hsa-embedded/stm32lab/anschluss.rst

====== ========= =========== ========= =========== ===========
Pinout     STM32VLDISCOVERY           hsa-pyboard  STM32LAB
------ --------------------- --------------------- -----------
 P1    board pin component   board pin component   component
       name                  name
====== ========= =========== ========= =========== ===========
  1      GND                   GND       
  2      NC                    NC
  3      3V3                  (3V3)
  4      VBAT                 (VBAT)
  5      PC13                 (PC13)
  6      PC14      OSC32_IN
  7      PC15      OSC32_OUT
  8      PD0       OSC_IN
  9      PD1       OSC_OUT
  10     NRST
  11     PC0                                          
  12     PC1
  13     PC2
  14     PC3
  15     PA0      User 
                  Button
  16     PA1      
  17     PA2
  18     PA3
  19     PA4
  20     PA5
  21     PA6
  22     PA7
  23     PC4
  24     PC5
  25     PB0
  26     PB2
  27     PB2
  28     GND
====== ========= =========== ========= =========== ===========

====== ========= =========== ========= =========== ===========
Pinout     STM32VLDISCOVERY           hsa-pyboard  STM32LAB
------ --------------------- --------------------- -----------
 P2    board pin component   board pin component   component
       name                  name
====== ========= =========== ========= =========== ===========
  1      GND                   GND       
  2      PC6      
  3      PC7
  4      PC8      LED_BL
  5      PC9      LED_GR
  6      PA8      MC0         
  7      PA9      
  8      PA10
  9      PA11
  10     PA12
  11     PA13     JTAG
                  JTMS
                  SWDIO                       
  12     PA14     JTAG
                  JTCK 
                  SWCLK                       
  13     PA15     JTAG
  14     PC10     
  15     PC11                     
  16     PC12
  17     PD2 
  18     PB3      JTAG JTDO
  19     PB4      JTAG 
                  NJTRST
  20     PB5      
  21     PB6
  22     PB7
  23     BOOT0    BOOT0
  24     PB8      
  25     PB9
  26     EXT_5V   
  27     NC
  28     GND
====== ========= =========== ========= =========== ===========

====== ========= =========== ========= =========== ===========
Pinout     STM32VLDISCOVERY           hsa-pyboard  STM32LAB
------ --------------------- --------------------- -----------
 P3    board pin component   board pin component   component
       name                  name
====== ========= =========== ========= =========== ===========
  1      PB10                 PB10
  2      PB11                 PB11      
  3      PB12                 PB12
  4      PB13                 PB13
  5      PB14                 PB14
  6      PB15                 PB15
====== ========= =========== ========= =========== ===========
