hsa-embedded/stm32lab/Software/examples/usart/wire.txt

USART Wiring:

PA9  -> RX (USB-to-Serial)
PA10 -> TX (USB-to-Serial)

see media/wire.jpg
