hsa-embedded/stm32lab/Design/20140815/hsa_stm32_board.brd

## EAGLE design Design/20140815/hsa_stm32_board.brd (2014-10-14)

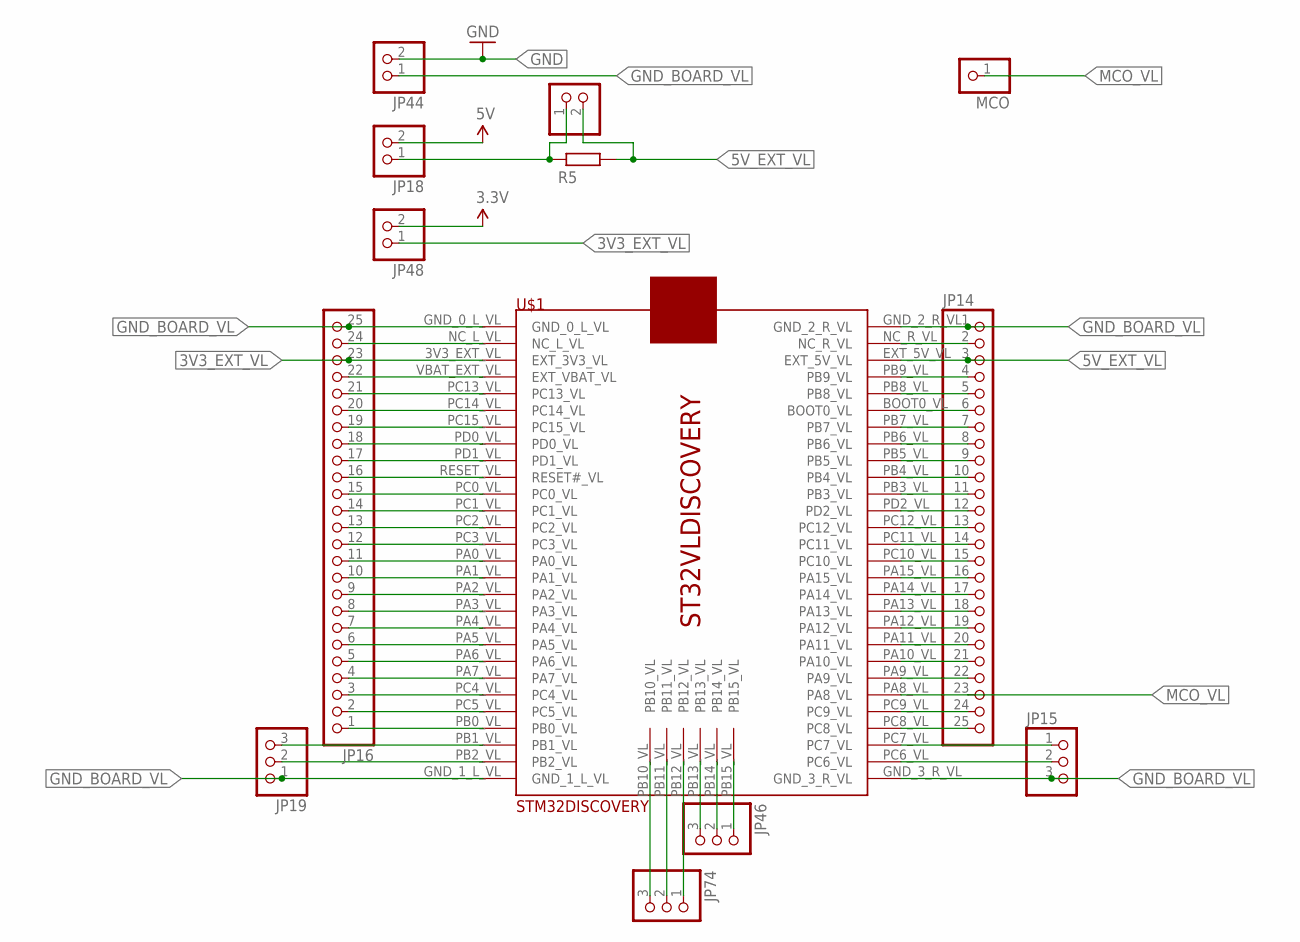
[picture p1: schematic hsa_stm32_board.sch, sheet 1]

Parts:
JP14, JP16: PINHD-1X25; 1X25
JP15, JP19, JP46, JP74: PINHD-1X3; 1X03
JP18, JP44, JP48, JP75: PINHD-1X2/90; 1X02/90
MCO: PINHD-1X1; 1X01
R5: R-EU_0207/10; 0207/10
U$1: STM32DISCOVERY

Connections:
3.3V: JP48.2; also elsewhere on the board
3V3_EXT_VL: JP16.23, JP48.1, U$1.3V3_EXT_VL (EXT_3V3_VL)
5V: JP18.2; also elsewhere on the board
5V_EXT_VL: JP14.3, JP75.2, R5.2, U$1.EXT_5V_VL
GND: JP44.2; also elsewhere on the board
GND_BOARD_VL: JP14.1, JP15.3, JP16.25, JP19.1, JP44.1, U$1.GND_0_L_VL, U$1.GND_1_L_VL, U$1.GND_2_R_VL, U$1.GND_3_R_VL
MCO_VL: JP14.23, MCO.1, U$1.PA8_VL
unnamed: JP18.1, JP75.1, R5.1
unnamed: JP14.2, U$1.NC_R_VL
unnamed: JP14.4, U$1.PB9_VL
unnamed: JP14.5, U$1.PB8_VL
unnamed: JP14.6, U$1.BOOT0_VL
unnamed: JP14.7, U$1.PB7_VL
unnamed: JP14.8, U$1.PB6_VL
unnamed: JP14.9, U$1.PB5_VL
unnamed: JP14.10, U$1.PB4_VL
unnamed: JP14.11, U$1.PB3_VL
unnamed: JP14.12, U$1.PD2_VL
unnamed: JP14.13, U$1.PC12_VL
unnamed: JP14.14, U$1.PC11_VL
unnamed: JP14.15, U$1.PC10_VL
unnamed: JP14.16, U$1.PA15_VL
unnamed: JP14.17, U$1.PA14_VL
unnamed: JP14.18, U$1.PA13_VL
unnamed: JP14.19, U$1.PA12_VL
unnamed: JP14.20, U$1.PA11_VL
unnamed: JP14.21, U$1.PA10_VL
unnamed: JP14.22, U$1.PA9_VL
unnamed: JP14.24, U$1.PC9_VL
unnamed: JP14.25, U$1.PC8_VL
unnamed: JP15.1, U$1.PC7_VL
unnamed: JP15.2, U$1.PC6_VL
unnamed: JP16.1, U$1.PB0_VL
unnamed: JP16.2, U$1.PC5_VL
unnamed: JP16.3, U$1.PC4_VL
unnamed: JP16.4, U$1.PA7_VL
unnamed: JP16.5, U$1.PA6_VL
unnamed: JP16.6, U$1.PA5_VL
unnamed: JP16.7, U$1.PA4_VL
unnamed: JP16.8, U$1.PA3_VL
unnamed: JP16.9, U$1.PA2_VL
unnamed: JP16.10, U$1.PA1_VL
unnamed: JP16.11, U$1.PA0_VL
unnamed: JP16.12, U$1.PC3_VL
unnamed: JP16.13, U$1.PC2_VL
unnamed: JP16.14, U$1.PC1_VL
unnamed: JP16.15, U$1.PC0_VL
unnamed: JP16.16, U$1.RESET_VL (RESET#_VL)
unnamed: JP16.17, U$1.PD1_VL
unnamed: JP16.18, U$1.PD0_VL
unnamed: JP16.19, U$1.PC15_VL
unnamed: JP16.20, U$1.PC14_VL
unnamed: JP16.21, U$1.PC13_VL
unnamed: JP16.22, U$1.VBAT_EXT_VL (EXT_VBAT_VL)
unnamed: JP16.24, U$1.NC_L_VL
unnamed: JP19.2, U$1.PB2_VL
unnamed: JP19.3, U$1.PB1_VL
unnamed: JP46.1, U$1.PB15_VL
unnamed: JP46.2, U$1.PB14_VL
unnamed: JP46.3, U$1.PB13_VL
unnamed: JP74.1, U$1.PB12_VL
unnamed: JP74.2, U$1.PB11_VL
unnamed: JP74.3, U$1.PB10_VL

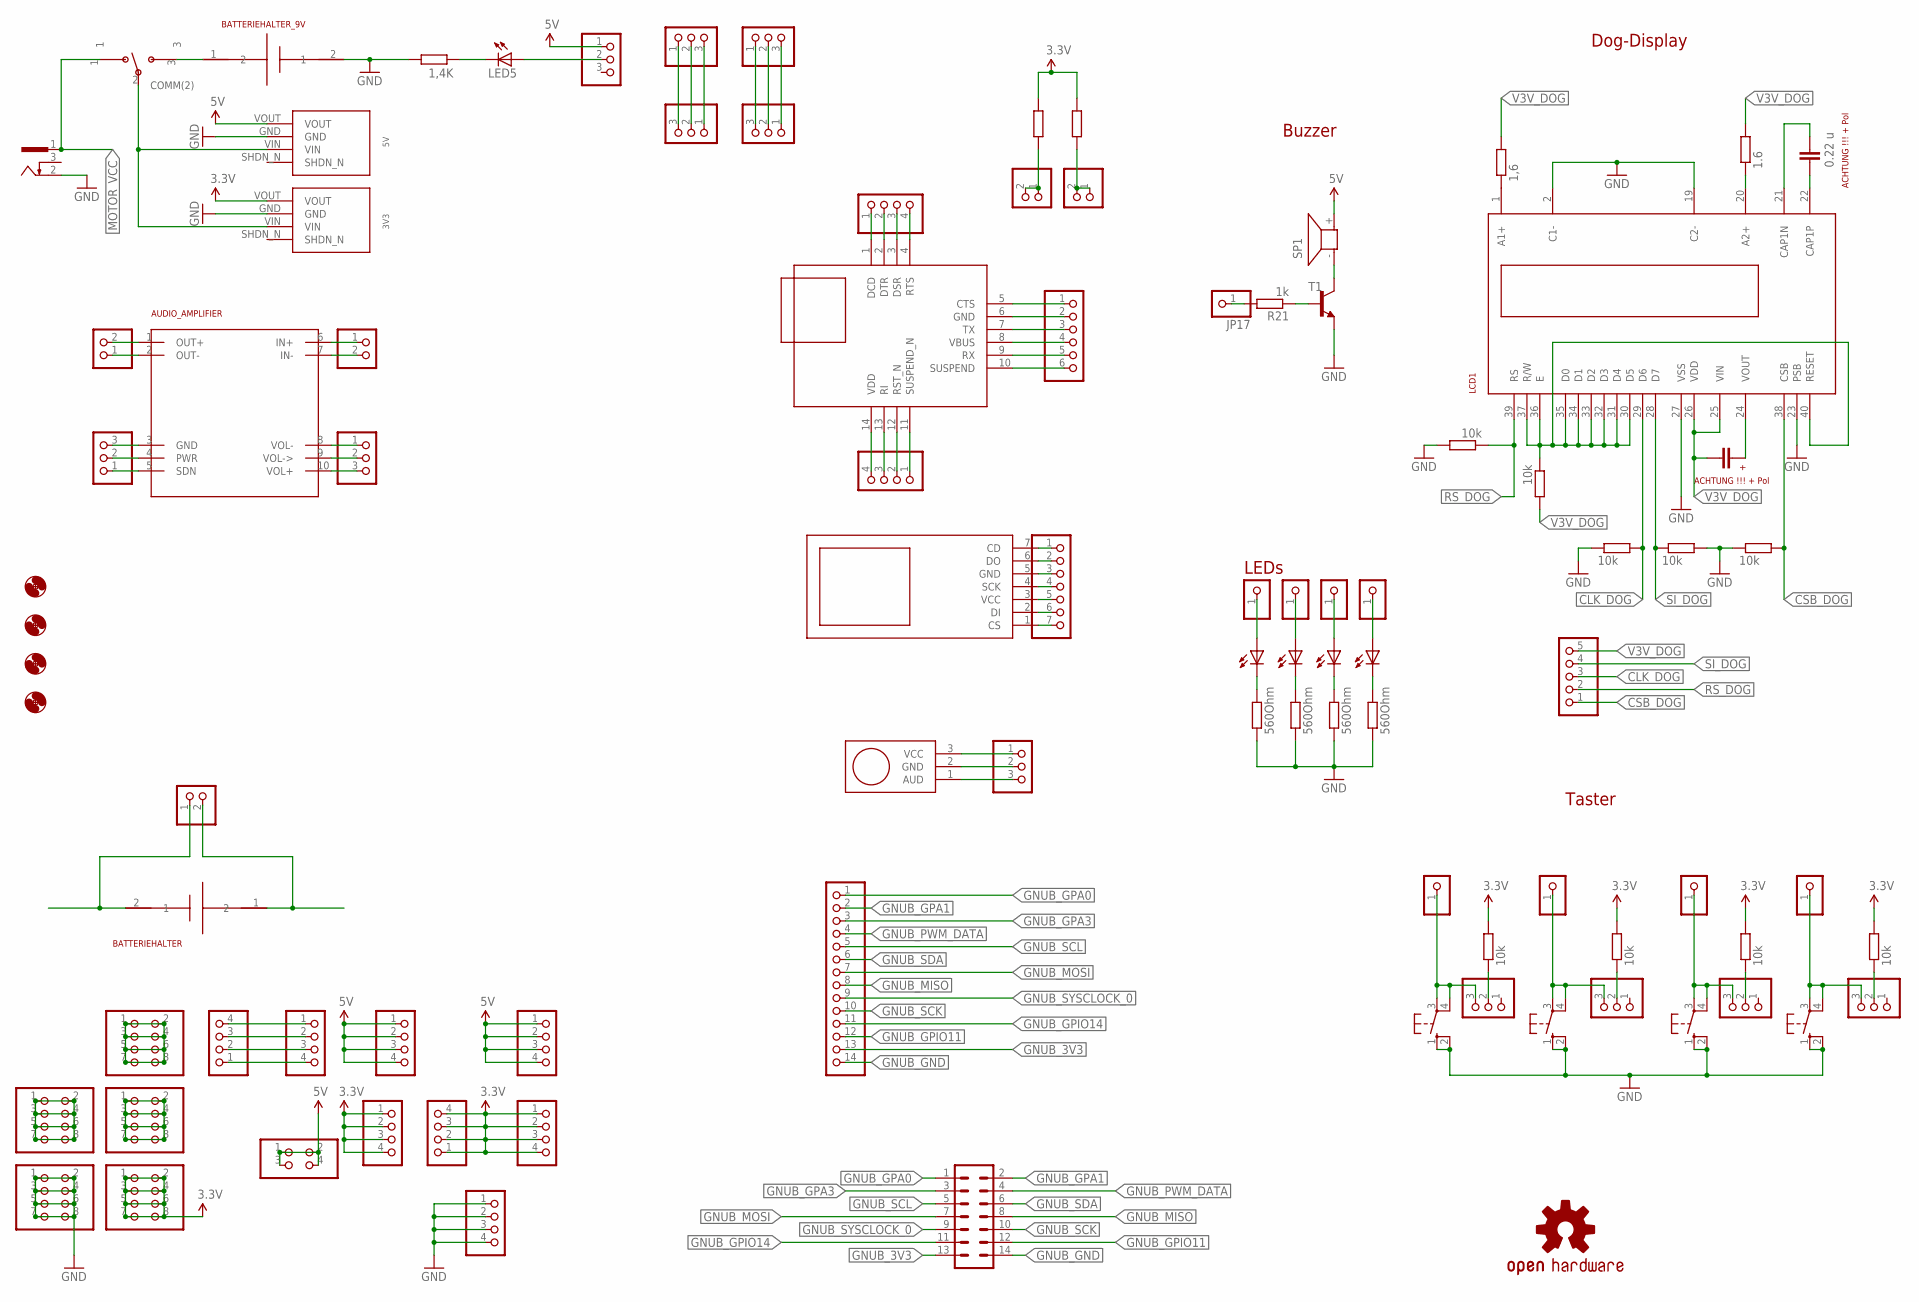
[picture p2: schematic hsa_stm32_board.sch, sheet 2]

Parts:
3V3, 5V: VOLTAGE_REGULATOR; VOL_REG
C2: 0.22 u; C025-040X050
C3: 1 u; C025-040X050
H1, H2, H3, H4: MOUNT-HOLE2.8; 2,8
JP1: PINHD-1X5; 1X05
JP4, JP30, JP33, JP34, JP50, JP52, JP59, JP60, JP61, JP62: PINHD-1X3; 1X03
JP5, JP6, JP7, JP8, JP9, JP10, JP11, JP12, JP17: PINHD-1X1; 1X01
JP24, JP28, JP29, JP36, JP37, JP40, JP41, JP42, JP47: PINHD-1X4; 1X04
JP27: PINHD-1X4/90; 1X04/90
JP31, JP32, JP43, JP65, JP66: PINHD-1X2; 1X02
JP38: PINHD-1X6; 1X06
JP39: PINHD-1X7; 1X07
JP45, JP67, JP68, JP69, JP70: PINHD-2X4; 2X04
JP49, JP51: PINHD-1X3/90; 1X03/90
JP64: PINHD-1X14; 1X14
JP71: PINHD-2X2; 2X02
LCD1: ZEITERFASSUNG_-OPTO_DOGM
LED1, LED2, LED3, LED4, LED5: LED5MM
LOGO1: OSHW-LOGOL; OSHW-LOGO-L
R1, R2, R3, R4: 560Ohm; 0207/10
R6: 1,4K; 0207/10
R7: 1.6; 0207/10
R8: 1,6; 0207/10
R9, R10, R11, R12, R13, R14, R15, R16, R17: 10k; 0207/10
R21: 1k; 0207/10
R22, R23: R-EU_0207/10; 0207/10
S1, S2, S3, S4: CPU-K_MODULE_REV3.0_SWITCH-OMRON_10-XX; CPU-K_MODULE_REV3.0_SWITCH-OMRON_B3F-10XX
SP1: BUZZER_F/PMX04; BUZZER_F/PMX04A
SV3: ML14
T1: TRANSISTOR_BC337; TRANSISTOR_TO92
U$2: USB_TO_SERIAL_ADAPTER; USB_TO_SERIAL
U$4: KIPPSCHALTER(EIN,AUS,EIN); KIPPSCHALTER
U$5: MIC
U$6: BATTERIEHALTER; BH_KZH_20
U$7: BATTERIEHALTER_9V
U$9: AUDIO_AMPLIFIER
U$12: MICRO_SD_HALTER; MIKRO_SD_HALTER
X1: 733980-62

Connections:
3.3V: 3V3.VOUT, JP29.1, JP29.2, JP29.3, JP29.4, JP41.1, JP41.2, JP41.3, JP41.4, JP47.1, JP47.2, JP47.3, JP47.4, JP70.1, JP70.2, JP70.3, JP70.4, JP70.5, JP70.6, JP70.7, JP70.8, R14.2, R15.2, R16.2, R17.2, R22.2, R23.2; also elsewhere on the board
5V: 5V.VOUT, JP4.1, JP28.1, JP28.2, JP28.3, JP28.4, JP40.1, JP40.2, JP40.3, JP40.4, JP71.1, JP71.2, JP71.3, JP71.4, SP1.+ (2); also elsewhere on the board
CLK_DOG: JP1.3, LCD1.29 (D6), R11.2
CSB_DOG: JP1.1, LCD1.38 (CSB), R13.2
GND: 3V3.GND, 5V.GND, JP42.1, JP42.2, JP42.3, JP42.4, JP67.1, JP67.2, JP67.3, JP67.4, JP67.5, JP67.6, JP67.7, JP67.8, LCD1.2 (C1-), LCD1.19 (C2-), LCD1.23 (PSB), LCD1.27 (VSS), R1.1, R2.1, R3.1, R4.1, R6.2, R9.2, R11.1, R12.2, R13.1, S1.1 (S), S1.2 (S1), S2.1 (S), S2.2 (S1), S3.1 (S), S3.2 (S1), S4.1 (S), S4.2 (S1), T1.1 (E), U$7.2 (1), X1.2; also elsewhere on the board
GNUB_3V3: JP64.13, SV3.13
GNUB_GND: JP64.14, SV3.14
GNUB_GPA0: JP64.1, SV3.1
GNUB_GPA1: JP64.2, SV3.2
GNUB_GPA3: JP64.3, SV3.3
GNUB_GPIO11: JP64.12, SV3.12
GNUB_GPIO14: JP64.11, SV3.11
GNUB_MISO: JP64.8, SV3.8
GNUB_MOSI: JP64.7, SV3.7
GNUB_PWM_DATA: JP64.4, SV3.4
GNUB_SCK: JP64.10, SV3.10
GNUB_SCL: JP64.5, SV3.5
GNUB_SDA: JP64.6, SV3.6
GNUB_SYSCLOCK_0: JP64.9, SV3.9
MOTOR_VCC: U$4.1, X1.1; also elsewhere on the board
unnamed: C2.2, LCD1.22 (CAP1P)
unnamed: C2.1, LCD1.21 (CAP1N)
unnamed: LCD1.20 (A2+), R7.1
unnamed: LCD1.30 (D5), LCD1.31 (D4), LCD1.32 (D3), LCD1.33 (D2), LCD1.34 (D1), LCD1.35 (D0), LCD1.36 (E), LCD1.37 (R/W), LCD1.40 (RESET), R10.1
unnamed: LCD1.1 (A1+), R8.1
unnamed: C3.2, LCD1.24 (VOUT)
unnamed: LED4.K (C), R4.2
unnamed: LED3.K (C), R3.2
unnamed: LED2.K (C), R2.2
unnamed: LED1.K (C), R1.2
unnamed: JP6.1, LED2.A
unnamed: JP7.1, LED3.A
unnamed: JP8.1, LED4.A
unnamed: 3V3.VIN, 5V.VIN, U$4.2 (COMM(2))
unnamed: JP62.2, R14.1
unnamed: JP61.2, R15.1
unnamed: JP9.1, JP62.3, S1.3, S1.4 (P1)
unnamed: JP10.1, JP61.3, S2.3, S2.4 (P1)
unnamed: JP60.2, R16.1
unnamed: JP59.2, R17.1
unnamed: JP11.1, JP60.3, S3.3, S3.4 (P1)
unnamed: JP12.1, JP59.3, S4.3, S4.4 (P1)
unnamed: U$4.3, U$7.1 (2)
unnamed: LED5.K (C), R6.1
unnamed: JP4.2, LED5.A
unnamed: JP5.1, LED1.A
unnamed: SP1.- (1), T1.3 (C)
unnamed: JP43.1, U$6.2 (1)
unnamed: JP17.1, R21.2
unnamed: JP43.2, U$6.1 (2)
unnamed: JP24.4, JP27.1
unnamed: JP24.3, JP27.2
unnamed: JP24.2, JP27.3
unnamed: JP24.1, JP27.4
unnamed: JP32.2, U$9.1 (OUT+)
unnamed: JP32.1, U$9.2 (OUT-)
unnamed: JP31.1, U$9.6 (IN+)
unnamed: JP31.2, U$9.7 (IN-)
unnamed: JP34.1, U$9.8 (VOL-)
unnamed: JP49.3, JP50.1
unnamed: JP49.2, JP50.2
unnamed: JP49.1, JP50.3
unnamed: JP30.1, U$5.3 (VCC)
unnamed: JP30.2, U$5.2 (GND)
unnamed: JP30.3, U$5.1 (AUD)
unnamed: JP34.2, U$9.9 (VOL->)
unnamed: JP34.3, U$9.10 (VOL+)
unnamed: JP33.3, U$9.3 (GND)
unnamed: JP33.2, U$9.4 (PWR)
unnamed: JP33.1, U$9.5 (SDN)
unnamed: JP36.1, U$2.1 (DCD)
unnamed: JP36.2, U$2.2 (DTR)
unnamed: JP36.3, U$2.3 (DSR)
unnamed: JP36.4, U$2.4 (RTS)
unnamed: JP37.1, U$2.11 (SUSPEND_N)
unnamed: JP37.2, U$2.12 (RST_N)
unnamed: JP37.3, U$2.13 (RI)
unnamed: JP37.4, U$2.14 (VDD)
unnamed: JP38.1, U$2.5 (CTS)
unnamed: JP38.2, U$2.6 (GND)
unnamed: JP38.3, U$2.7 (TX)
unnamed: JP38.4, U$2.8 (VBUS)
unnamed: JP38.5, U$2.9 (RX)
unnamed: JP38.6, U$2.10 (SUSPEND)
unnamed: JP39.1, U$12.7 (CD)
unnamed: JP39.2, U$12.6 (DO)
unnamed: JP39.3, U$12.5 (GND)
unnamed: JP39.4, U$12.4 (SCK)
unnamed: JP39.5, U$12.3 (VCC)
unnamed: JP39.6, U$12.2 (DI)
unnamed: JP39.7, U$12.1 (CS)
unnamed: JP51.3, JP52.1
unnamed: JP51.2, JP52.2
unnamed: JP51.1, JP52.3
unnamed: R21.1, T1.2 (B)
unnamed: JP65.1, JP65.2, R23.1
unnamed: JP66.1, JP66.2, R22.1
unnamed: JP45.1, JP45.2, JP45.3, JP45.4, JP45.5, JP45.6, JP45.7, JP45.8
unnamed: JP68.1, JP68.2, JP68.3, JP68.4, JP68.5, JP68.6, JP68.7, JP68.8
unnamed: JP69.1, JP69.2, JP69.3, JP69.4, JP69.5, JP69.6, JP69.7, JP69.8
RS_DOG: JP1.2, LCD1.39 (RS), R9.1
SI_DOG: JP1.4, LCD1.28 (D7), R12.1
V3V_DOG: C3.1, JP1.5, LCD1.25 (VIN), LCD1.26 (VDD), R7.2, R8.2, R10.2

Notes on the sheet:
Dog-Display
Taster
Buzzer
LEDs
ACHTUNG !!! + Pol

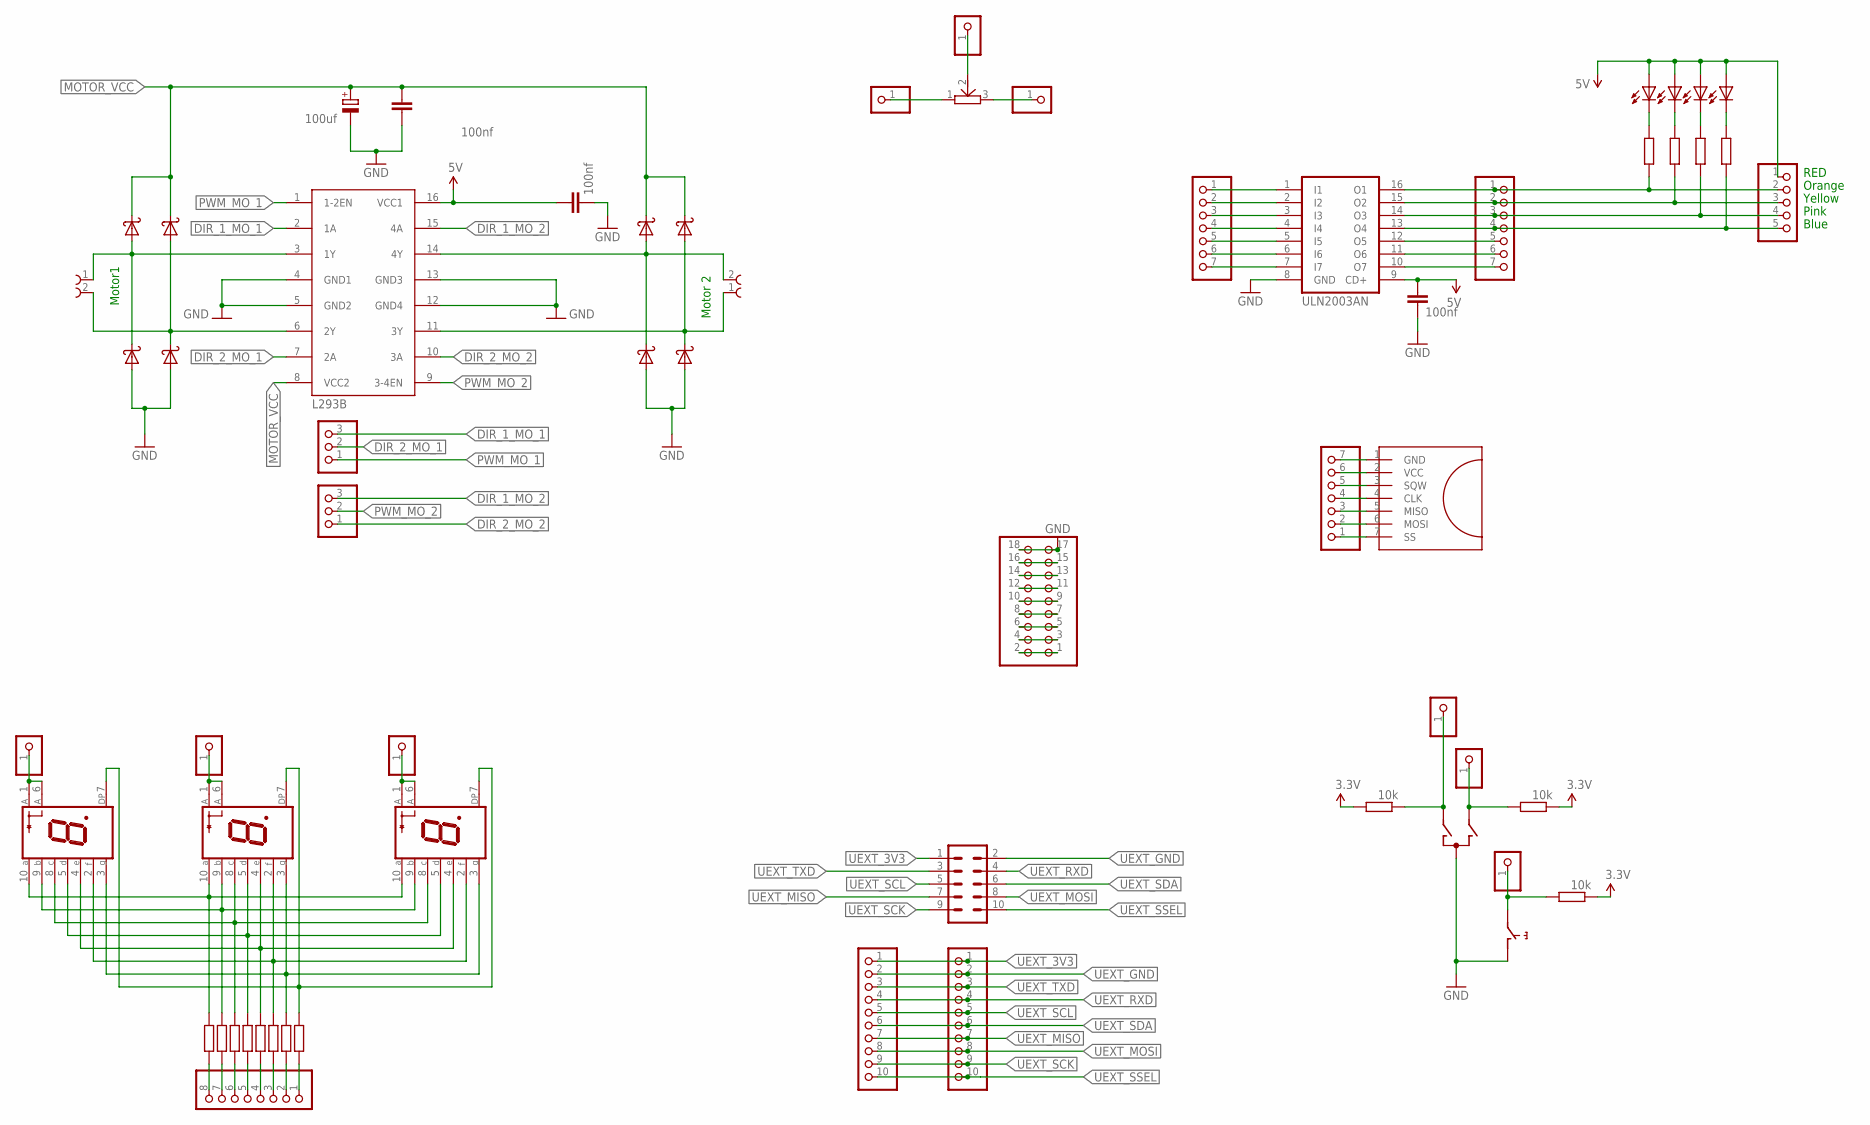
[picture p3: schematic hsa_stm32_board.sch, sheet 3]

Parts:
C4, C5, C6: 100nf; RCL_C025-040X050
C7: 100uf; RCL_E2,5-6
D1, D2, D3, D4, D5, D6, D7, D8: 1N5819; DO41-10
IC1: ULN2003AN; DIL16
IC2: L293D; DIL16
JP2, JP3, JP13, JP23, JP53, JP54, JP55, JP72, JP73: PINHD-1X1; 1X01
JP20, JP63: PINHD-1X10; 1X10
JP21, JP26, JP35: PINHD-1X7; 1X07
JP22: PINHD-1X8; 1X08
JP25: PINHD-1X5/90; 1X05/90
JP56: PINHD-2X9; 2X09
JP57, JP58: PINHD-1X3; 1X03
K1, K2: 691210910002
LED6, LED7, LED8: LA-401MD; LA-401
LED9, LED10, LED11, LED12: LED3MM
R18, R19, R20: 10k; 0207/10
R24, R25, R26, R27, R28, R29, R30, R31, R32, R33, R34, R35: R-EU_0207/10; 0207/10
SV2: CON-HARTING-ML_ML10
SW1: EC12E_SW; ALPS_EC12E_SW
U$10: RTC
U$17: THUMBWHEEL_POTI

Connections:
3.3V: R18.1, R19.2, R20.1; also elsewhere on the board
5V: C4.1, C6.1, IC1.9 (CD+), IC2.16 (VCC1), JP25.1, LED9.A, LED10.A, LED11.A, LED12.A; also elsewhere on the board
DIR_1_MO_1: IC2.2 (1A), JP57.3
DIR_1_MO_2: IC2.15 (4A), JP58.3
DIR_2_MO_1: IC2.7 (2A), JP57.2
DIR_2_MO_2: IC2.10 (3A), JP58.1
GND: C4.2, C5.2, C6.2, C7.-, D3.A, D4.A, D7.A, D8.A, IC1.8 (GND), IC2.4 (GND1), IC2.5 (GND2), IC2.12 (GND4), IC2.13 (GND3), JP56.17, JP56.18, SW1.C, SW1.D (1); also elsewhere on the board
MOTOR_VCC: C5.1, C7.+, D1.C, D2.C, D5.C, D6.C, IC2.8 (VCC2); also elsewhere on the board
unnamed: JP2.1, R19.1, SW1.A
unnamed: LED9.K (C), R32.2
unnamed: LED10.K (C), R34.2
unnamed: JP3.1, R18.2, SW1.B
unnamed: JP13.1, R20.2, SW1.E (2)
unnamed: D2.A, D4.C, IC2.14 (4Y), K1.2
unnamed: IC1.12 (O5), JP21.5
unnamed: IC1.11 (O6), JP21.6
unnamed: IC1.10 (O7), JP21.7
unnamed: IC1.5 (I5), JP26.5
unnamed: IC1.16 (O1), JP21.1, JP25.2, R32.1
unnamed: IC1.15 (O2), JP21.2, JP25.3, R34.1
unnamed: IC1.6 (I6), JP26.6
unnamed: IC1.7 (I7), JP26.7
unnamed: JP56.1, JP56.2
unnamed: JP56.3, JP56.4
unnamed: IC1.14 (O3), JP21.3, JP25.4, R33.1
unnamed: IC1.13 (O4), JP21.4, JP25.5, R35.1
unnamed: JP56.5, JP56.6
unnamed: IC1.4 (I4), JP26.4
unnamed: IC1.3 (I3), JP26.3
unnamed: IC1.2 (I2), JP26.2
unnamed: IC1.1 (I1), JP26.1
unnamed: JP56.7, JP56.8
unnamed: JP56.9, JP56.10
unnamed: JP56.11, JP56.12
unnamed: JP35.1, U$10.7 (SS)
unnamed: JP35.2, U$10.6 (MOSI)
unnamed: JP35.3, U$10.5 (MISO)
unnamed: JP35.4, U$10.4 (CLK)
unnamed: JP35.5, U$10.3 (SQW)
unnamed: JP35.6, U$10.2 (VCC)
unnamed: JP35.7, U$10.1 (GND)
unnamed: D1.A, D3.C, IC2.11 (3Y), K1.1
unnamed: JP55.1, U$17.1 (A)
unnamed: JP54.1, U$17.2 (W)
unnamed: D6.A, D8.C, IC2.3 (1Y), K2.1
unnamed: D5.A, D7.C, IC2.6 (2Y), K2.2
unnamed: JP53.1, U$17.3 (B)
unnamed: LED12.K (C), R35.2
unnamed: LED11.K (C), R33.2
unnamed: JP56.13, JP56.14
unnamed: JP56.15, JP56.16
unnamed: JP22.8, R24.1
unnamed: LED6.9 (B), LED7.9 (B), LED8.9 (B), R25.2
unnamed: LED6.8 (C), LED7.8 (C), LED8.8 (C), R26.2
unnamed: LED6.5 (D), LED7.5 (D), LED8.5 (D), R27.2
unnamed: LED6.4 (E), LED7.4 (E), LED8.4 (E), R28.2
unnamed: LED6.2 (F), LED7.2 (F), LED8.2 (F), R29.2
unnamed: LED6.3 (G), LED7.3 (G), LED8.3 (G), R30.2
unnamed: LED6.7 (DP), LED7.7 (DP), LED8.7 (DP), R31.2
unnamed: LED6.10 (A), LED7.10 (A), LED8.10 (A), R24.2
unnamed: JP22.7, R25.1
unnamed: JP22.6, R26.1
unnamed: JP22.5, R27.1
unnamed: JP22.4, R28.1
unnamed: JP22.3, R29.1
unnamed: JP22.2, R30.1
unnamed: JP22.1, R31.1
unnamed: JP72.1, LED6.1 (A), LED6.6 (A)
unnamed: JP73.1, LED7.1 (A), LED7.6 (A)
unnamed: JP23.1, LED8.1 (A), LED8.6 (A)
PWM_MO_1: IC2.1 (1-2EN), JP57.1
PWM_MO_2: IC2.9 (3-4EN), JP58.2
UEXT_3V3: JP20.1, JP63.1, SV2.1
UEXT_GND: JP20.2, JP63.2, SV2.2
UEXT_MISO: JP20.7, JP63.7, SV2.7
UEXT_MOSI: JP20.8, JP63.8, SV2.8
UEXT_RXD: JP20.4, JP63.4, SV2.4
UEXT_SCK: JP20.9, JP63.9, SV2.9
UEXT_SCL: JP20.5, JP63.5, SV2.5
UEXT_SDA: JP20.6, JP63.6, SV2.6
UEXT_SSEL: JP20.10, JP63.10, SV2.10
UEXT_TXD: JP20.3, JP63.3, SV2.3

Notes on the sheet:
L293B
Motor 2
Motor1
RED
Orange
Yellow
Pink
Blue

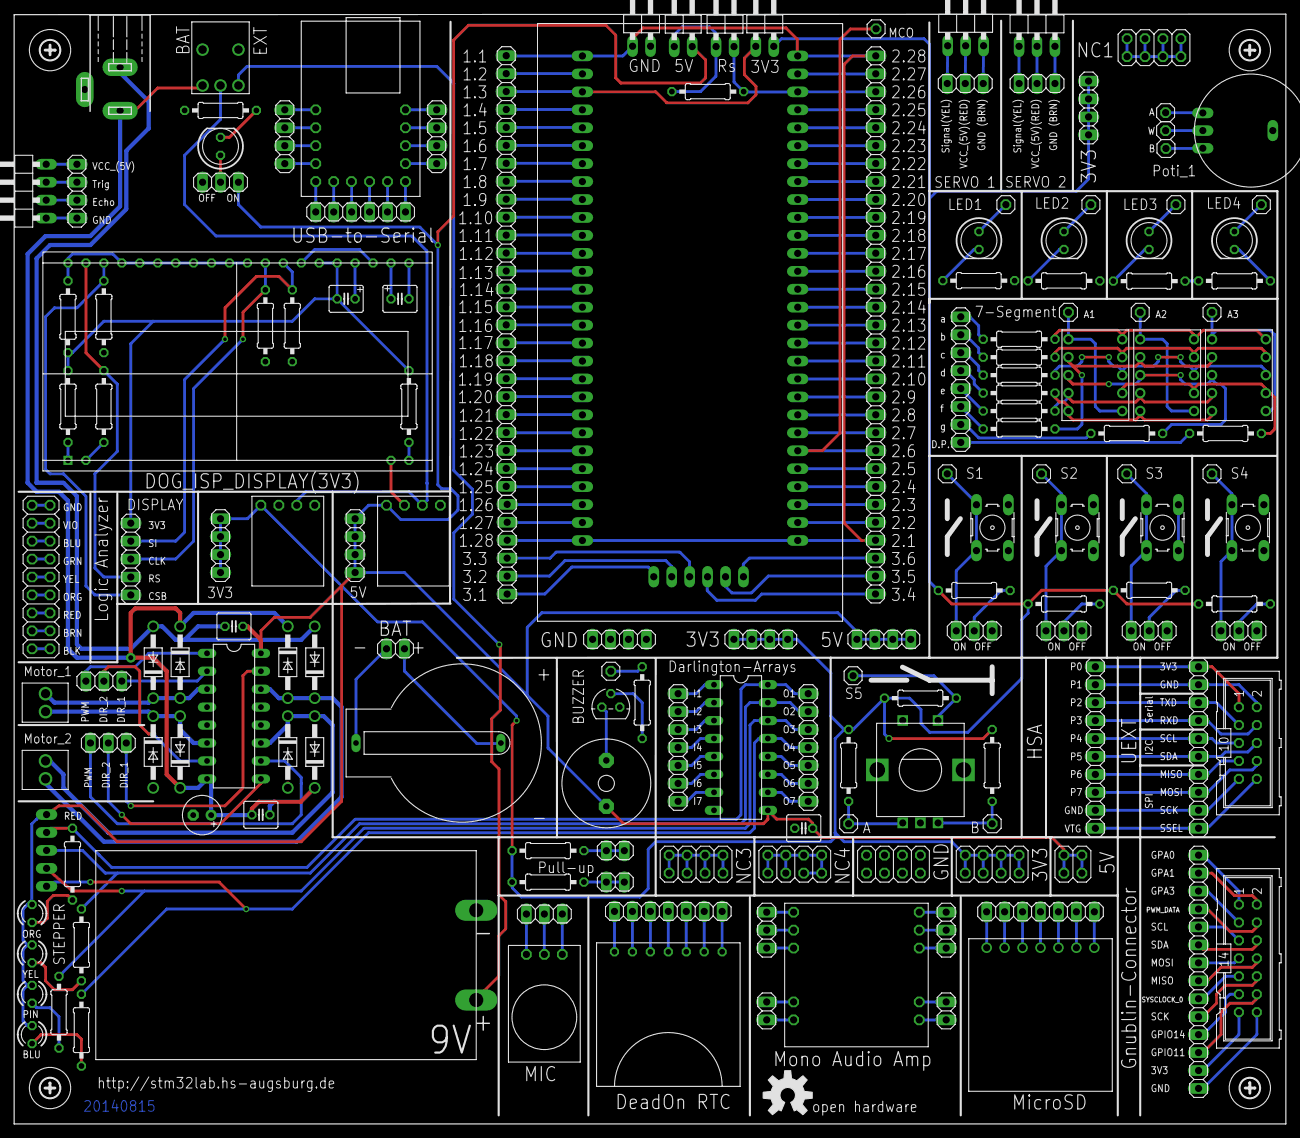
[picture p4: board hsa_stm32_board.brd from above]

Board: 2 copper layers, 180.0 x 157.1 mm, 169 parts (1 on the bottom side), 241 nets.
