hsa-embedded/stm32lab/Software/examples/usart/main.c

/*
# main.c
# Copyright (C) 2014 Ferdinand Saufler
# 
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
# You should have received a copy of the GNU General Public License along
# with this program.  If not, see <http://www.gnu.org/licenses/>.
*/

#include "usart.h"

int main(void) 
{
    usart_init();
	
    while (1)
    {
        char *s = "the brown fox jumps over the lazy dog.\r\n";
        usart_sends((char*)s);
        delay(5e5);
    }
}
