hsa-embedded/stm32lab/(notices)

Notices in the files:
Software/examples/usart/main.c:
under the terms of the GNU General Public License as published by the
Free Software Foundation, either version 3 of the License, or
(at your option) any later version.
parts and their libraries:
SparkFun-Aesthetics: Licensing: CC v3.0 Share-Alike You are welcome to use this library for commercial purposes.
Wuerth_Elektronik_eiCan_14_Terminal_Bloc: Copyright: Würth Elektronik
